tmdrake/Archeus_Register_Clock/Pictures/Arduino-Mega-Pinout-High-Res.jpg

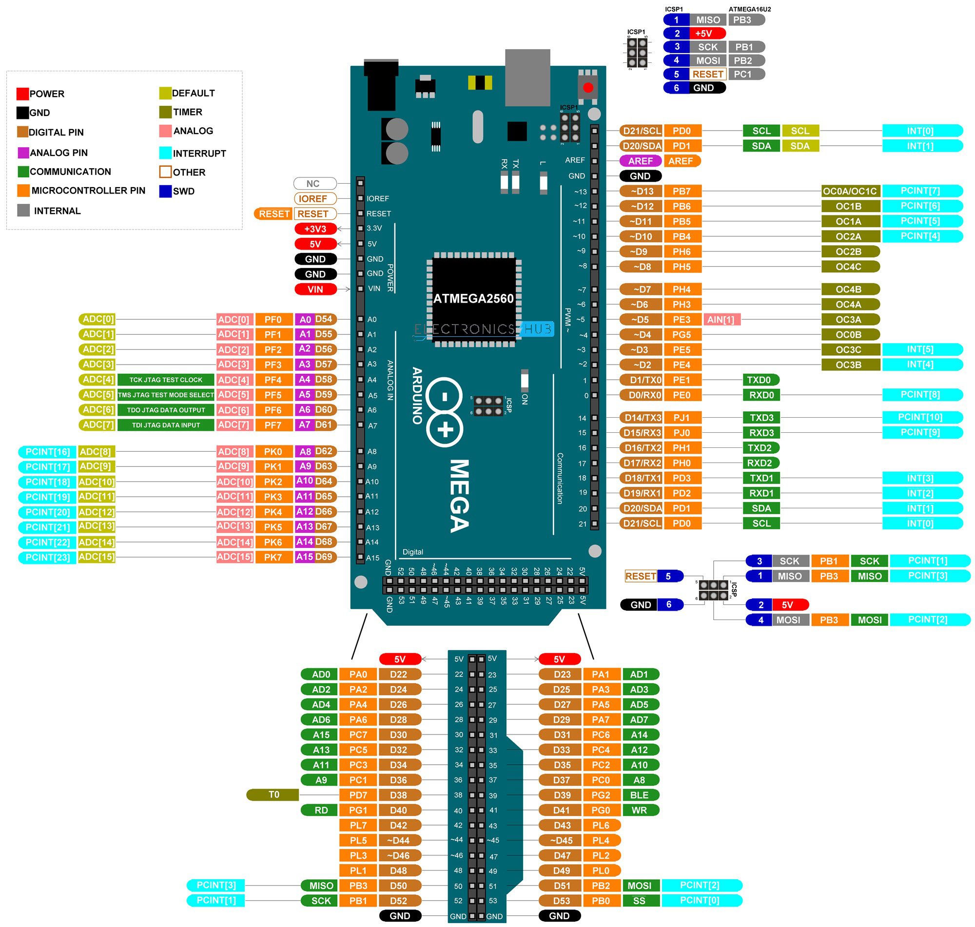
Pictures/Arduino-Mega-Pinout-High-Res.jpg
