tmdrake/Archeus_Register_Clock/Pictures/20241225_130737.jpg

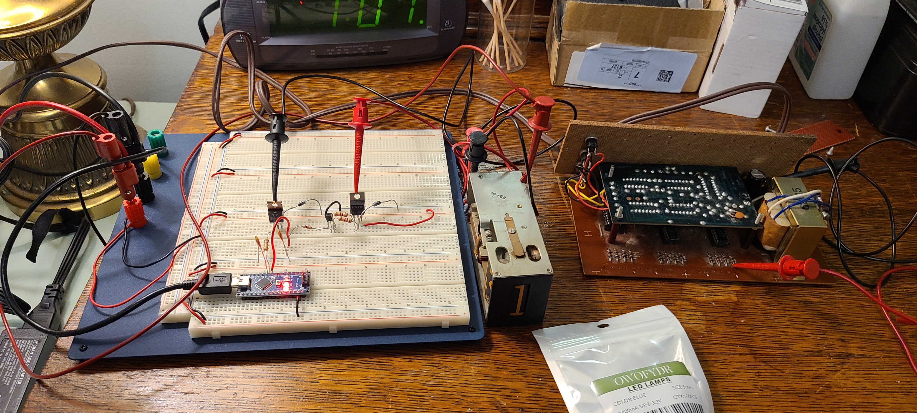
Pictures/20241225_130737.jpg
