tmdrake/Archeus_Register_Clock/README.md

# Archeus_Register_Clock
Driver and Clock for a mechanical tele-register clock.

See video: https://www.youtube.com/watch?v=ujtkTZA01rc

Frans lab did a video on it.
https://www.youtube.com/watch?v=c6l2vbn6IXM&t=259s
