tmdrake/Archeus_Register_Clock/Pictures/174908d9403c4f6be737b881e9c67110.png

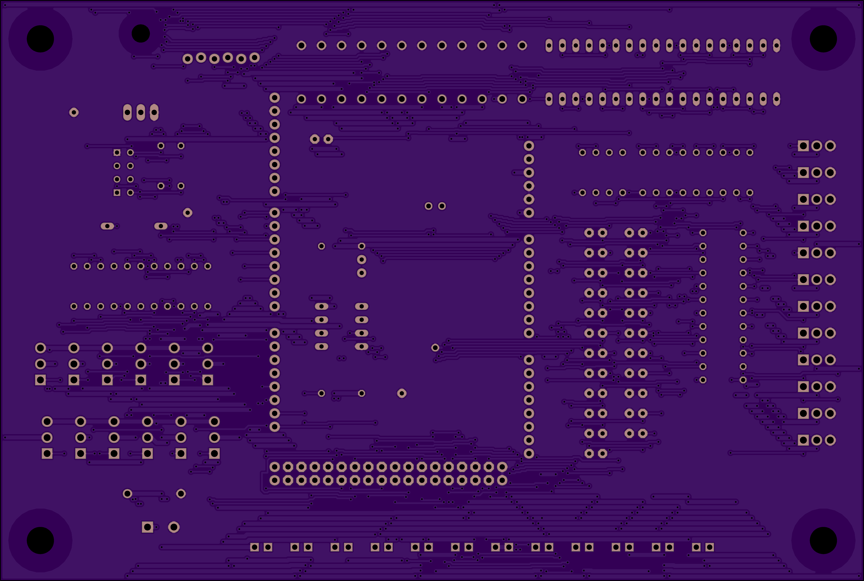
Pictures/174908d9403c4f6be737b881e9c67110.png
