tmdrake/Archeus_Register_Clock/Pictures/20241226_222516.jpg

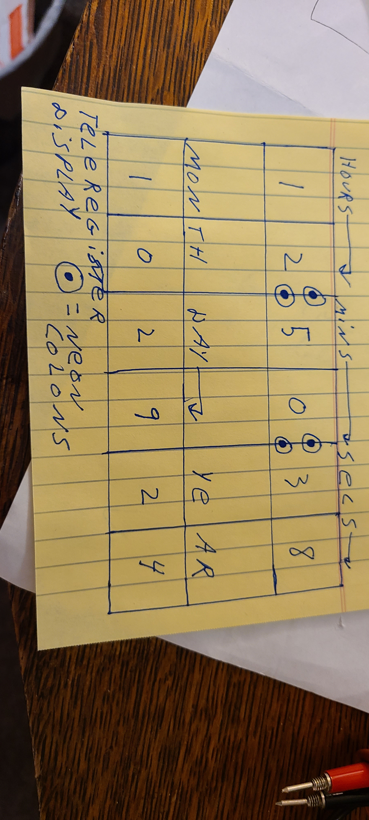
Pictures/20241226_222516.jpg
