tmdrake/Archeus_Register_Clock/Pictures/b3c67cfdca87e934cea376d334c10484.png

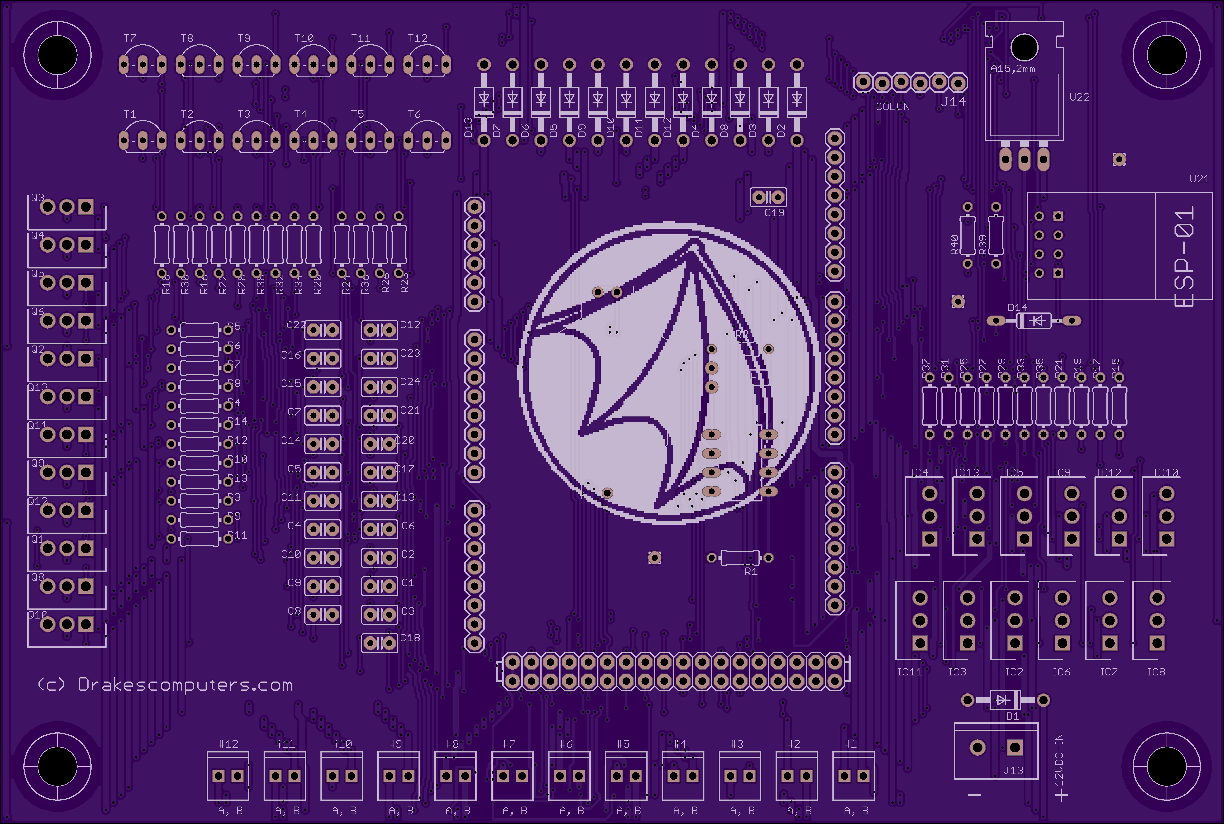
Pictures/b3c67cfdca87e934cea376d334c10484.png
