tmdrake/Archeus_Register_Clock/Schematic/Schematic 1.png

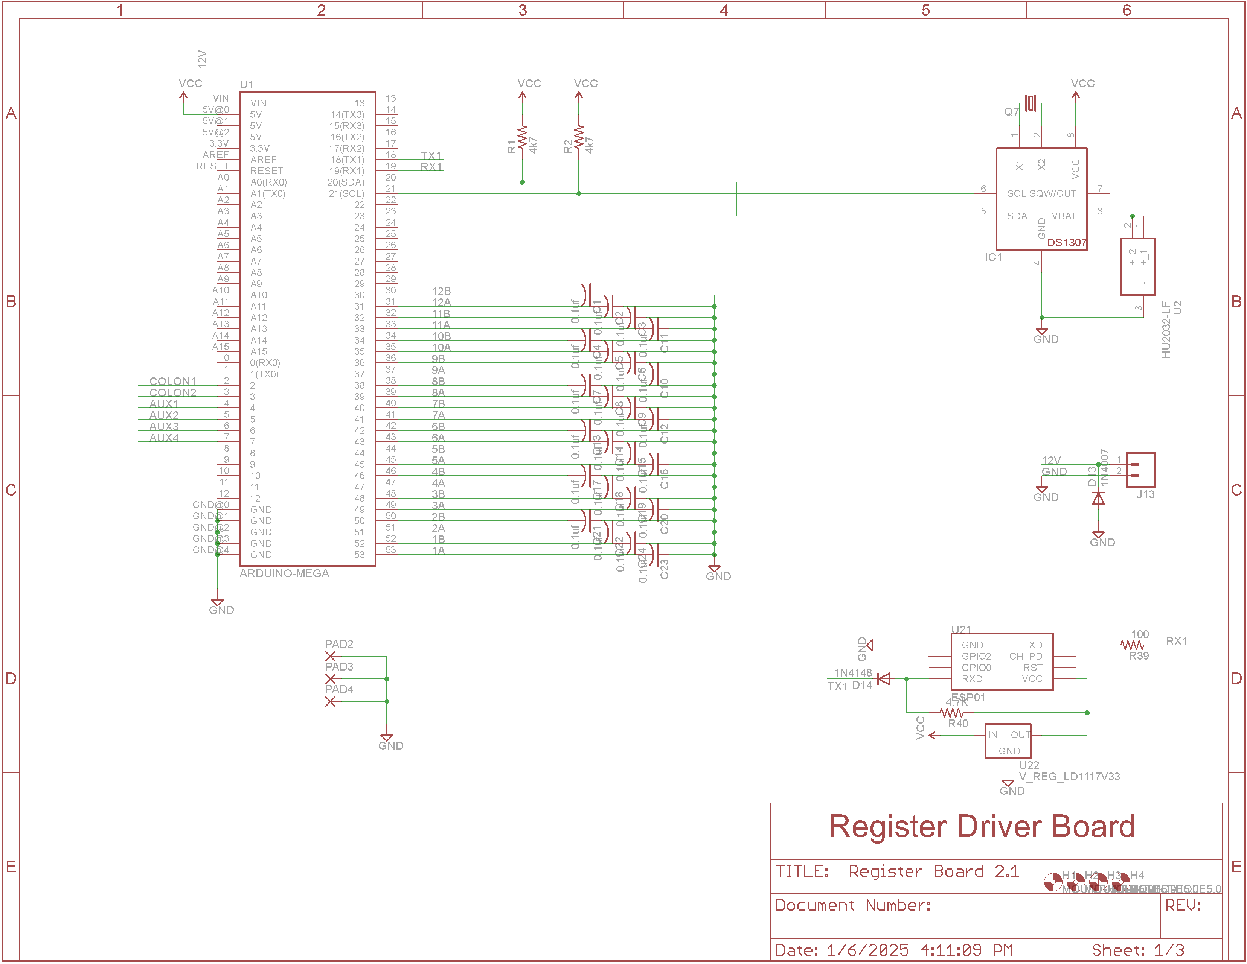
Schematic/Schematic 1.png
