tmdrake/Archeus_Register_Clock/Schematic/Schematic 2.png

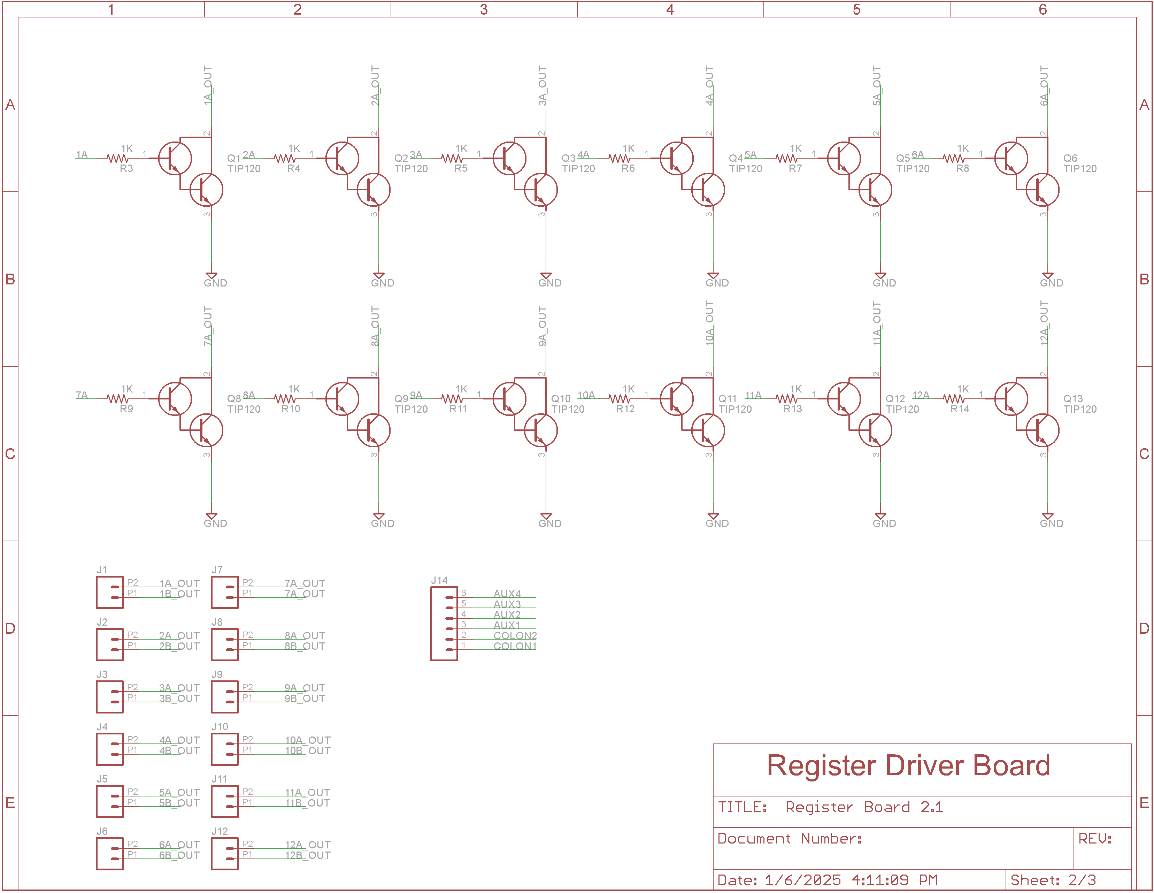
Schematic/Schematic 2.png
