tmdrake/Archeus_Register_Clock/Schematic/Schematic 3.png

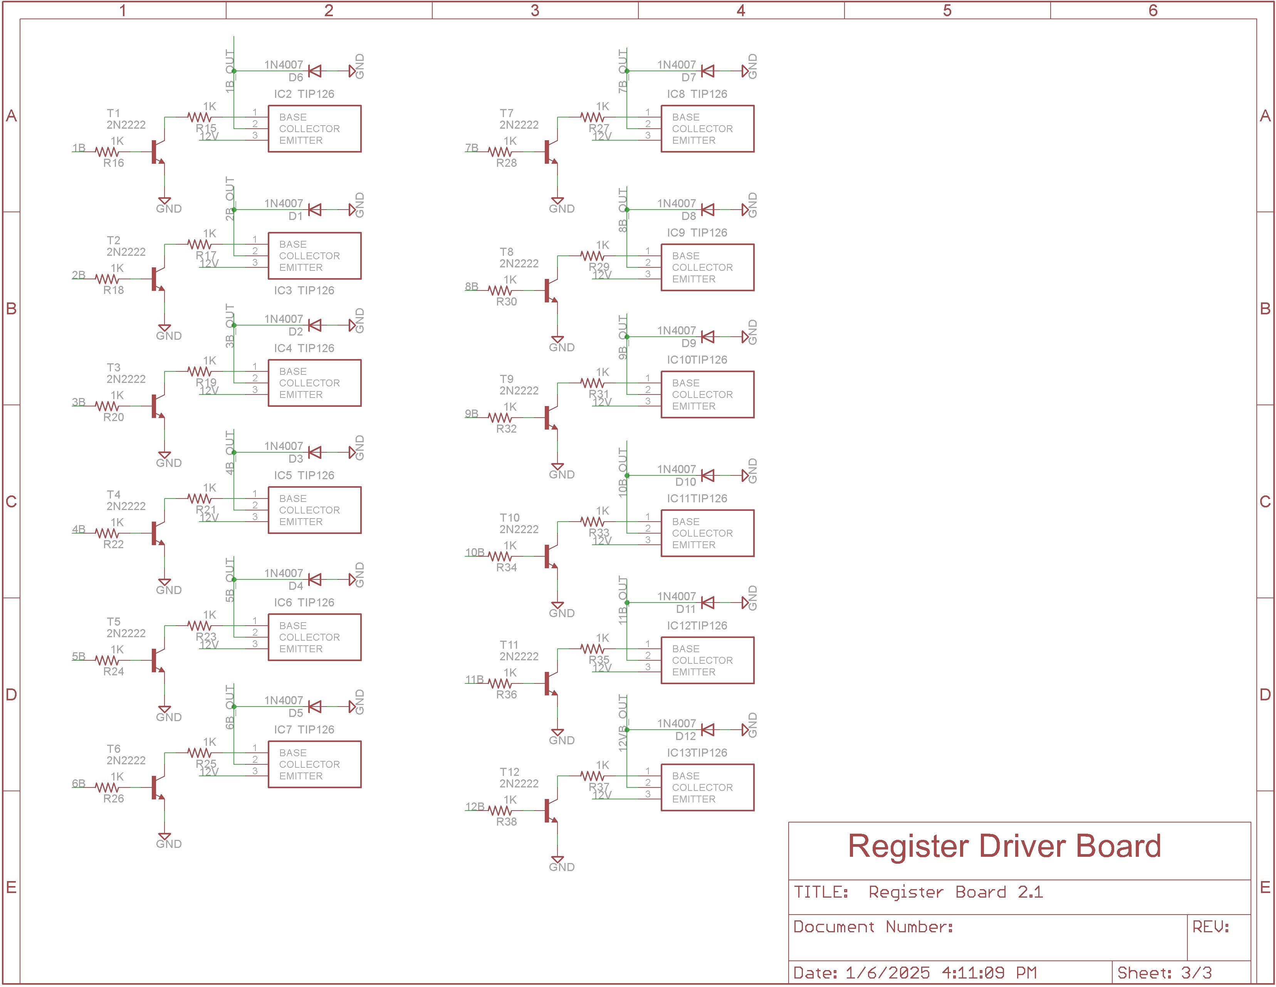
Schematic/Schematic 3.png
