tmdrake/Archeus_Register_Clock/Schematic/Register Board 2.1.brd

## EAGLE design Schematic/Register Board 2.1.brd (2025-01-07)

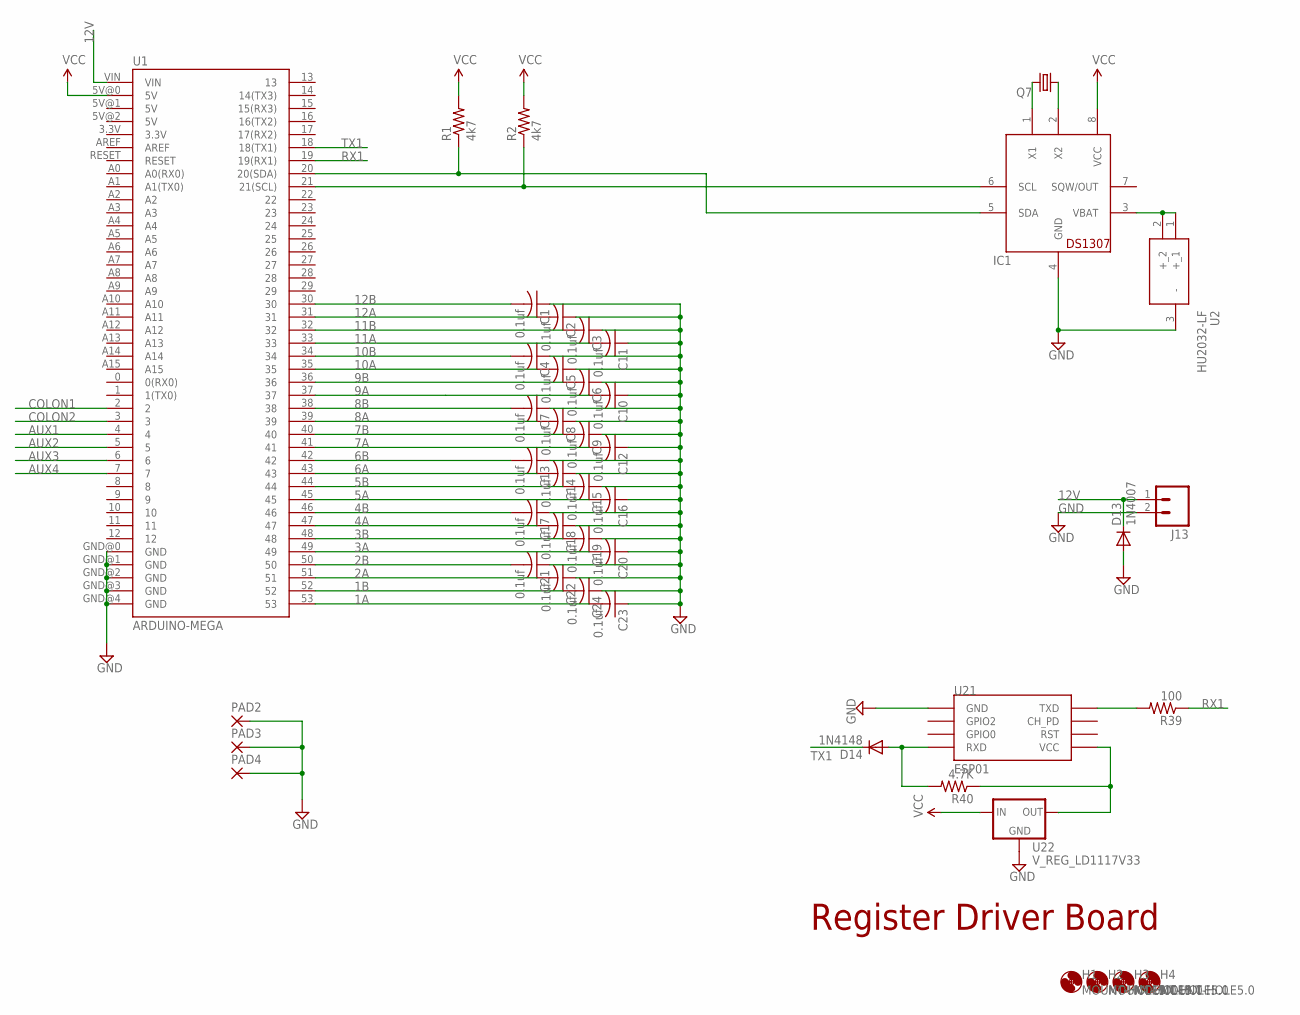
[picture p9: schematic Register Board 2.1.sch, sheet 1]

Parts:
C1, C2, C3, C4, C5, C6, C7, C8, C9, C10, C11, C12, C13, C14, C15, C16, C17, C18, C19, C20, C21, C22, C23, C24: 0.1uf; C025-025X050
D13: 1N4007; DO41-10
D14: 1N4148; DO35-10
H1, H2, H3, H4: MOUNT-HOLE5.0; 5,0
IC1: DS1307; DIL08
J13: M025MM; SCREWTERMINAL-5MM-2
PAD2, PAD3, PAD4: 1,6/0,8
Q7: CRYSTALTC26H; TC26H
R1, R2: 4k7; 0204/7
R39: 100; 0204/7
R40: 4.7K; 0204/7
U1: ARDUINO-MEGA; ARDUINO_MEGA_PINSONLY
U2: HU2032-LF; HU2032LF
U21: ESP01
U22: V_REG_LD1117V33; 78XXL

Connections:
1A: C23.2, U1.53; also elsewhere on the board
1B: C24.2, U1.52; also elsewhere on the board
2A: C22.2, U1.51; also elsewhere on the board
2B: C21.2, U1.50; also elsewhere on the board
3A: C20.2, U1.49; also elsewhere on the board
3B: C19.2, U1.48; also elsewhere on the board
4A: C18.2, U1.47; also elsewhere on the board
4B: C17.2, U1.46; also elsewhere on the board
5A: C16.2, U1.45; also elsewhere on the board
5B: C15.2, U1.44; also elsewhere on the board
6A: C14.2, U1.43; also elsewhere on the board
6B: C13.2, U1.42; also elsewhere on the board
7A: C12.2, U1.41; also elsewhere on the board
7B: C9.2, U1.40; also elsewhere on the board
8A: C8.2, U1.39; also elsewhere on the board
8B: C7.2, U1.38; also elsewhere on the board
9A: U1.37; also elsewhere on the board
9B: C6.2, U1.36; also elsewhere on the board
10A: C5.2, U1.35; also elsewhere on the board
10B: C4.2, U1.34; also elsewhere on the board
11A: C11.2, U1.33; also elsewhere on the board
11B: C3.2, U1.32; also elsewhere on the board
12A: C2.2, U1.31; also elsewhere on the board
12B: C1.2, U1.30; also elsewhere on the board
12V: D13.C, J13.1, U1.VIN; also elsewhere on the board
AUX1: U1.4; also elsewhere on the board
AUX2: U1.5; also elsewhere on the board
AUX3: U1.6; also elsewhere on the board
AUX4: U1.7; also elsewhere on the board
COLON1: U1.2; also elsewhere on the board
COLON2: U1.3; also elsewhere on the board
GND: C1.1, C2.1, C3.1, C4.1, C5.1, C6.1, C7.1, C8.1, C9.1, C10.1, C11.1, C12.1, C13.1, C14.1, C15.1, C16.1, C17.1, C18.1, C19.1, C20.1, C21.1, C22.1, C23.1, C24.1, D13.A, IC1.4 (GND), J13.2, PAD2.1, PAD3.1, PAD4.1, U1.GND@0 (GND), U1.GND@1 (GND), U1.GND@2 (GND), U1.GND@3 (GND), U1.GND@4 (GND), U2.3 (-), U21.GND, U22.IN (GND); also elsewhere on the board
unnamed: IC1.5 (SDA), R1.1, U1.20 (20(SDA))
unnamed: IC1.6 (SCL), R2.1, U1.21 (21(SCL))
unnamed: IC1.2 (X2), Q7.1
unnamed: IC1.1 (X1), Q7.2
unnamed: IC1.3 (VBAT), U2.1 (+_1), U2.2 (+_2)
unnamed: R39.2, U21.TX (TXD)
unnamed: R40.1, U21.VCC, U22.GND (OUT)
unnamed: D14.A, R40.2, U21.RX (RXD)
RX1: R39.1, U1.19 (19(RX1))
TX1: D14.C, U1.18 (18(TX1))
VCC: IC1.8 (VCC), R1.2, R2.2, U1.5V@0 (5V), U22.OUT (IN)

Notes on the sheet:
Register Driver Board

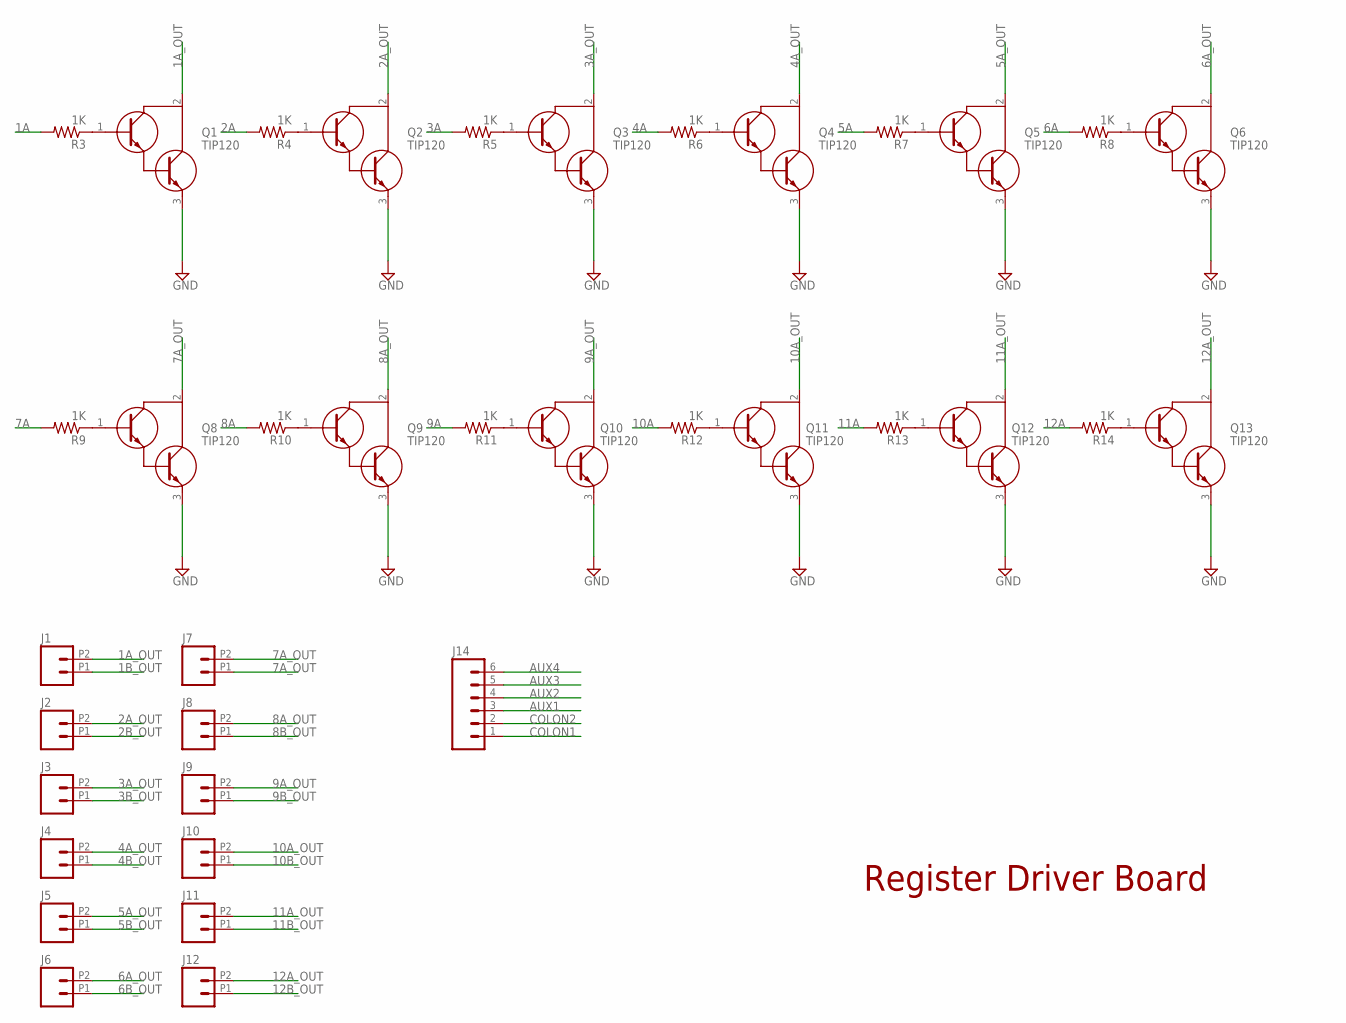
[picture p10: schematic Register Board 2.1.sch, sheet 2]

Parts:
J1, J2, J3, J4, J5, J6, J7, J8, J9, J10, J11, J12: M022.54MM_SCREWTERM; 1X02_2.54_SCREWTERM
J14: M06LOCK; 1X06_LOCK
Q1, Q2, Q3, Q4, Q5, Q6, Q8, Q9, Q10, Q11, Q12, Q13: TIP120; TO255P460X1020X2008-3P
R3, R4, R5, R6, R7, R8, R9, R10, R11, R12, R13, R14: 1K; 0204/7

Connections:
1A: R3.2; also elsewhere on the board
1A_OUT: J1.P2 (2), Q1.2 (C)
1B_OUT: J1.P1 (1); also elsewhere on the board
2A: R4.2; also elsewhere on the board
2A_OUT: J2.P2 (2), Q2.2 (C)
2B_OUT: J2.P1 (1); also elsewhere on the board
3A: R5.2; also elsewhere on the board
3A_OUT: J3.P2 (2), Q3.2 (C)
3B_OUT: J3.P1 (1); also elsewhere on the board
4A: R6.2; also elsewhere on the board
4A_OUT: J4.P2 (2), Q4.2 (C)
4B_OUT: J4.P1 (1); also elsewhere on the board
5A: R7.2; also elsewhere on the board
5A_OUT: J5.P2 (2), Q5.2 (C)
5B_OUT: J5.P1 (1); also elsewhere on the board
6A: R8.2; also elsewhere on the board
6A_OUT: J6.P2 (2), Q6.2 (C)
6B_OUT: J6.P1 (1); also elsewhere on the board
7A: R9.2; also elsewhere on the board
7A_OUT: J7.P1 (1), J7.P2 (2), Q8.2 (C)
8A: R10.2; also elsewhere on the board
8A_OUT: J8.P2 (2), Q9.2 (C)
8B_OUT: J8.P1 (1); also elsewhere on the board
9A: R11.2; also elsewhere on the board
9A_OUT: J9.P2 (2), Q10.2 (C)
9B_OUT: J9.P1 (1); also elsewhere on the board
10A: R12.2; also elsewhere on the board
10A_OUT: J10.P2 (2), Q11.2 (C)
10B_OUT: J10.P1 (1); also elsewhere on the board
11A: R13.2; also elsewhere on the board
11A_OUT: J11.P2 (2), Q12.2 (C)
11B_OUT: J11.P1 (1); also elsewhere on the board
12A: R14.2; also elsewhere on the board
12A_OUT: J12.P2 (2), Q13.2 (C)
12B_OUT: J12.P1 (1)
AUX1: J14.3; also elsewhere on the board
AUX2: J14.4; also elsewhere on the board
AUX3: J14.5; also elsewhere on the board
AUX4: J14.6; also elsewhere on the board
COLON1: J14.1; also elsewhere on the board
COLON2: J14.2; also elsewhere on the board
GND: Q1.3 (E), Q2.3 (E), Q3.3 (E), Q4.3 (E), Q5.3 (E), Q6.3 (E), Q8.3 (E), Q9.3 (E), Q10.3 (E), Q11.3 (E), Q12.3 (E), Q13.3 (E); also elsewhere on the board
unnamed: Q1.1 (B), R3.1
unnamed: Q2.1 (B), R4.1
unnamed: Q3.1 (B), R5.1
unnamed: Q4.1 (B), R6.1
unnamed: Q5.1 (B), R7.1
unnamed: Q6.1 (B), R8.1
unnamed: Q8.1 (B), R9.1
unnamed: Q9.1 (B), R10.1
unnamed: Q10.1 (B), R11.1
unnamed: Q11.1 (B), R12.1
unnamed: Q12.1 (B), R13.1
unnamed: Q13.1 (B), R14.1

Notes on the sheet:
Register Driver Board

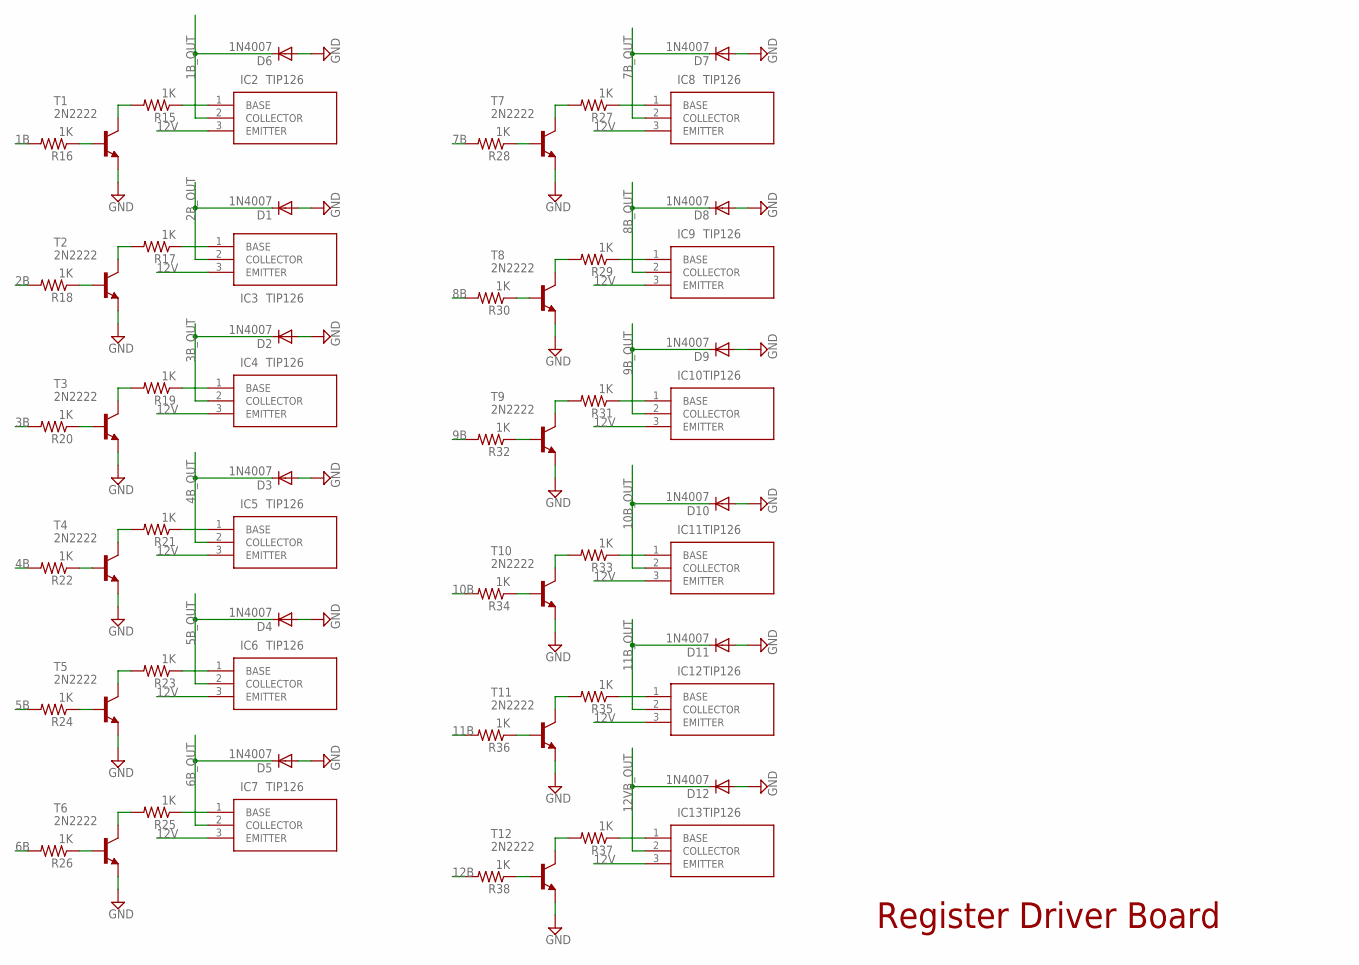
[picture p11: schematic Register Board 2.1.sch, sheet 3]

Parts:
D1, D2, D3, D4, D5, D6, D7, D8, D9, D10, D11, D12: 1N4007; DO41-10
IC2, IC3, IC4, IC5, IC6, IC7, IC8, IC9, IC10, IC11, IC12, IC13: TIP126; TO304P498X1010X2089-3P
R15, R16, R17, R18, R19, R20, R21, R22, R23, R24, R25, R26, R27, R28, R29, R30, R31, R32, R33, R34, R35, R36, R37, R38: 1K; 0204/7
T1, T2, T3, T4, T5, T6, T7, T8, T9, T10, T11, T12: 2N2222; TO92-EBC-OVAL

Connections:
1B: R16.2; also elsewhere on the board
1B_OUT: D6.C, IC2.2 (COLLECTOR); also elsewhere on the board
2B: R18.2; also elsewhere on the board
2B_OUT: D1.C, IC3.2 (COLLECTOR); also elsewhere on the board
3B: R20.2; also elsewhere on the board
3B_OUT: D2.C, IC4.2 (COLLECTOR); also elsewhere on the board
4B: R22.2; also elsewhere on the board
4B_OUT: D3.C, IC5.2 (COLLECTOR); also elsewhere on the board
5B: R24.2; also elsewhere on the board
5B_OUT: D4.C, IC6.2 (COLLECTOR); also elsewhere on the board
6B: R26.2; also elsewhere on the board
6B_OUT: D5.C, IC7.2 (COLLECTOR); also elsewhere on the board
7B: R28.2; also elsewhere on the board
7B_OUT: D7.C, IC8.2 (COLLECTOR)
8B: R30.2; also elsewhere on the board
8B_OUT: D8.C, IC9.2 (COLLECTOR); also elsewhere on the board
9B: R32.2; also elsewhere on the board
9B_OUT: D9.C, IC10.2 (COLLECTOR); also elsewhere on the board
10B: R34.2; also elsewhere on the board
10B_OUT: D10.C, IC11.2 (COLLECTOR); also elsewhere on the board
11B: R36.2; also elsewhere on the board
11B_OUT: D11.C, IC12.2 (COLLECTOR); also elsewhere on the board
12B: R38.2; also elsewhere on the board
12V: IC2.3 (EMITTER), IC3.3 (EMITTER), IC4.3 (EMITTER), IC5.3 (EMITTER), IC6.3 (EMITTER), IC7.3 (EMITTER), IC8.3 (EMITTER), IC9.3 (EMITTER), IC10.3 (EMITTER), IC11.3 (EMITTER), IC12.3 (EMITTER), IC13.3 (EMITTER); also elsewhere on the board
12VB_OUT: D12.C, IC13.2 (COLLECTOR)
GND: D1.A, D2.A, D3.A, D4.A, D5.A, D6.A, D7.A, D8.A, D9.A, D10.A, D11.A, D12.A, T1.E, T2.E, T3.E, T4.E, T5.E, T6.E, T7.E, T8.E, T9.E, T10.E, T11.E, T12.E; also elsewhere on the board
unnamed: IC2.1 (BASE), R15.1
unnamed: R15.2, T1.C
unnamed: R16.1, T1.B
unnamed: IC3.1 (BASE), R17.1
unnamed: R17.2, T2.C
unnamed: R18.1, T2.B
unnamed: IC4.1 (BASE), R19.1
unnamed: R19.2, T3.C
unnamed: R20.1, T3.B
unnamed: IC5.1 (BASE), R21.1
unnamed: R21.2, T4.C
unnamed: R22.1, T4.B
unnamed: IC6.1 (BASE), R23.1
unnamed: R23.2, T5.C
unnamed: R24.1, T5.B
unnamed: IC7.1 (BASE), R25.1
unnamed: R25.2, T6.C
unnamed: R26.1, T6.B
unnamed: IC8.1 (BASE), R27.1
unnamed: R27.2, T7.C
unnamed: R28.1, T7.B
unnamed: IC9.1 (BASE), R29.1
unnamed: R29.2, T8.C
unnamed: R30.1, T8.B
unnamed: IC10.1 (BASE), R31.1
unnamed: R31.2, T9.C
unnamed: R32.1, T9.B
unnamed: IC11.1 (BASE), R33.1
unnamed: R33.2, T10.C
unnamed: R34.1, T10.B
unnamed: IC12.1 (BASE), R35.1
unnamed: R35.2, T11.C
unnamed: R36.1, T11.B
unnamed: IC13.1 (BASE), R37.1
unnamed: R37.2, T12.C
unnamed: R38.1, T12.B

Notes on the sheet:
Register Driver Board

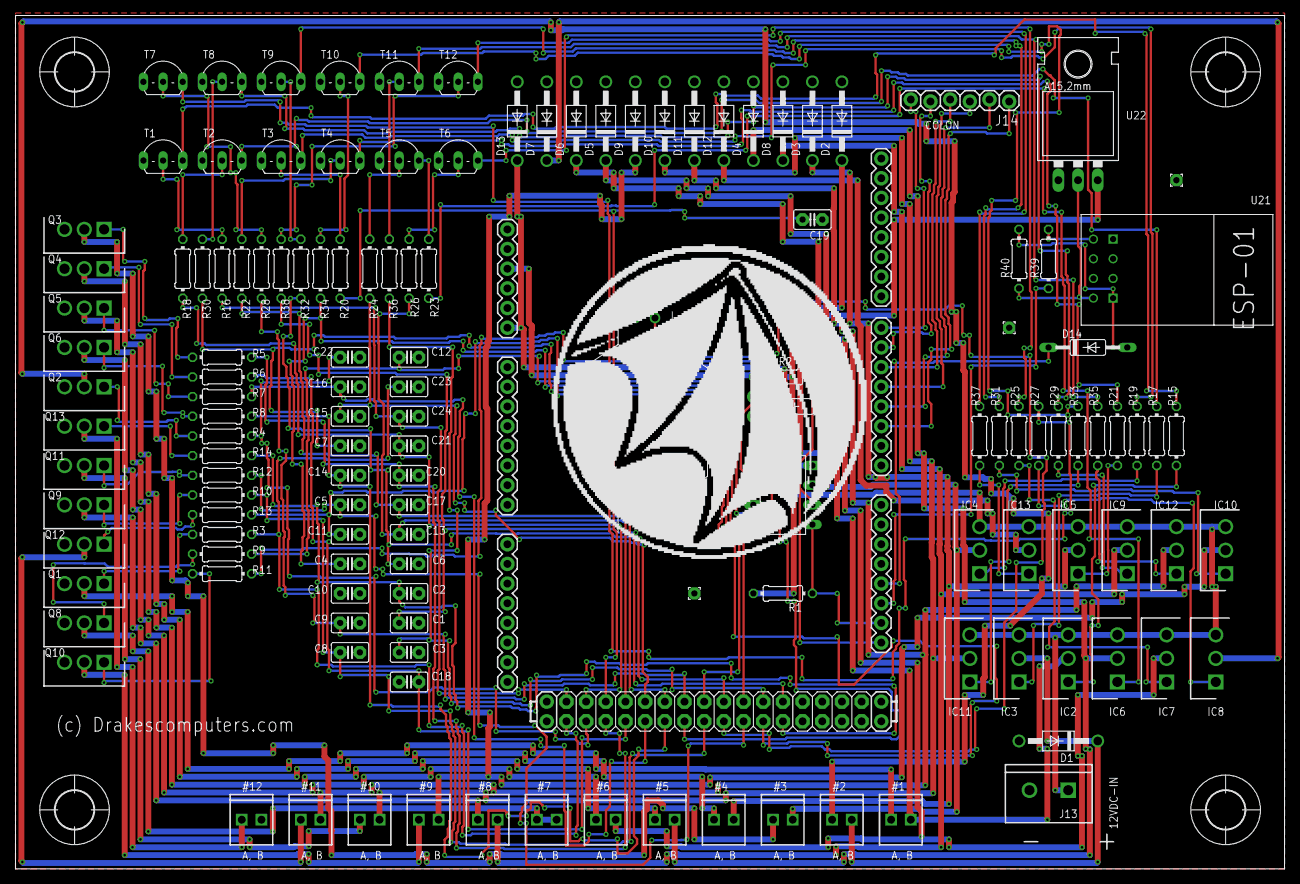
[picture p12: board Register Board 2.1.brd from above]

Board: 2 copper layers, 163.8 x 110.2 mm, 142 parts (0 on the bottom side), 115 nets.

Other parts of the board:
U$1: DCLOGO
