tmdrake/Archeus_Register_Clock/(commit log)

2025-01-07 Board Revision 2.1
    Updated the Board. Added a header for colon, buttons, etc.
    [Register Board 2.1.brd, Register Board 2.1.sch]
2025-02-01 Updates
    Fixed Register Library removed the Delay so seconds should work correctly once the time on the register matches the RTC...
    [Archeus_Register_Clock.ino, register.cpp, register.h]
2025-02-02 Fixed connection to WIFI
    Added interface via Serial0(Menu) and Serial1(Sync)
    [Archeus_Register_Clock.ino]
2025-04-10 Added Schematics
